Jaycar-Electronics/IoT-Button-Notifier/images/panel.jpg

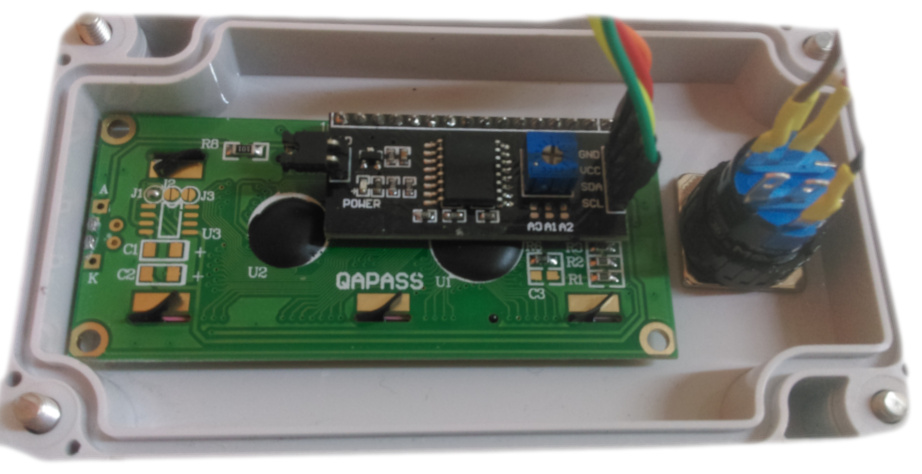
images/panel.jpg
